Jianghanlin/Multiple_Voltage_Acquisition_System/Keyshot渲染/渲染图.png

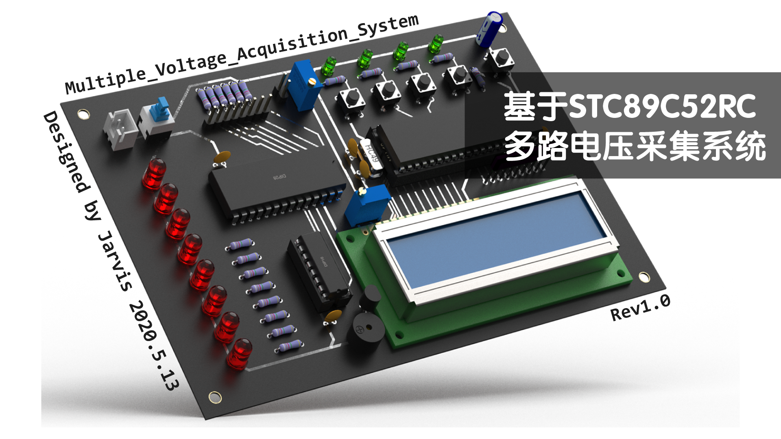
Keyshot渲染/渲染图.png
