Jianghanlin/Multiple_Voltage_Acquisition_System/报告/多通道采集控制系统-硬件.docx

目录

图目录

表目录

摘要

随着经济的飞速发展和科学技术水平的不断提高，智能数据采集系统在工业生产以及科学研究中得到了广泛的应用。在信息化时代，数据和信息无疑成为一种重要的资源，而数据采集系统的出现更是进一步促进了人机交互、对设备的自动检测控制等的实现，为现代化工业生产提供了方便。本次课程设计将阐述基于单片机的智能数据采集系统的设计要点及其具体方法，希望对基于单片机的智能数据采集系统的改造和创新做出应有的贡献。

此次课程设计利用型号为STC89C52RC的单片机，ADC0809，LCD1602，74HC138等电子元器件来实现对8通道模拟电压的采集并显示的功能。

关键字：电压采集、单片机、STC89C52、A/D转换

Abstract

With the rapid development of economy and the continuous improvement of science and technology, intelligent data acquisition system has been widely used in industrial production and scientific research. In the information age, data and information undoubtedly become an important resource, and the emergence of data acquisition system further promotes the realization of man-machine interaction and automatic detection and control of equipment, providing convenience for modern industrial production. This course design will elaborate the design essentials and specific methods of the intelligent data acquisition system based on the single chip microcomputer, hoping to make due contributions to the transformation and innovation of the intelligent data acquisition system based on the single chip microcomputer.

This course design USES the model STC89C52RC single-chip microcomputer, ADC0809, LCD1602, 74HC138 and other electronic components to realize the function of collecting and displaying the 8-channel analog voltage.

Key words: voltage acquisition, SCM, STC89C52, A/D conversion

# 多路数据采集控制系统

# 1 设计题目

单片机多路数据采集控制系统—实物制作。

# 2 设计目的

运用单片机原理及其应用等课程知识,根据题目要求进行软硬件系统的设计和调试，从而加深对本课程知识的理解，把学过的比较零碎的知识系统化，比较系统的学习开发单片机应用系统的基本步骤和基本方法，使学生应用知识能力、设计能力、调试能力以及报告撰写能力等有一定的提高。

# 3 设计内容及要求

用8051单片机设计数据采集控制系统，基本要求如下：

1、 可实现8路数据的采集，假设８路信号均为0-5V的电压信号；

2、 采集数据可通过LCD显示，显示格式为：[通道号] 电压值，如[０１]： ４.5V

3、 可通过键盘设置采集方式；（单点采集、多路巡测、采集时间间隔*）

4、 具有异常数据声音报警功能：对第一路数据可设置正常数据的上限值和下限值，当采集的数据出现异常，发出报警信号。

根据本人的设计，在原来基本要求的基础上，增加以下新增功能：

  1、 8路通道都可以单独设置上下限电压值并且可以人为通过按键调节并显示在LCD1602上，随时唤醒且自动保存数值。
  2、 通道电压不符合上下限值时，蜂鸣器打鸣，同时会有对应通道LED报警。
  3、 增加电源上电指示LED。
  4、 防止烧坏芯片，增加电源正负极插反指示LED。

# 4 总体设计

## 4.1 系统框图

此次多路数据采集控制系统包括：控制模块，电压采样模块，显示模块，按键模块，时钟模块，报警模块。

控制模块为单片机为STC89C52RC。电压采样模块为8位的AD转换芯片0809。显示模块为LCD1602A液晶显示屏。按键模块有按键、上拉电阻、LED构成。时钟模块为外接12MHz晶振。报警模块有声音报警模块和LED报警模块，声音报警模块由蜂鸣器和三极管构成；LED报警模块由74HC138和LED构成。另外还有其他滤波电容、电阻、LED等元件。其电路总设计框图如下：

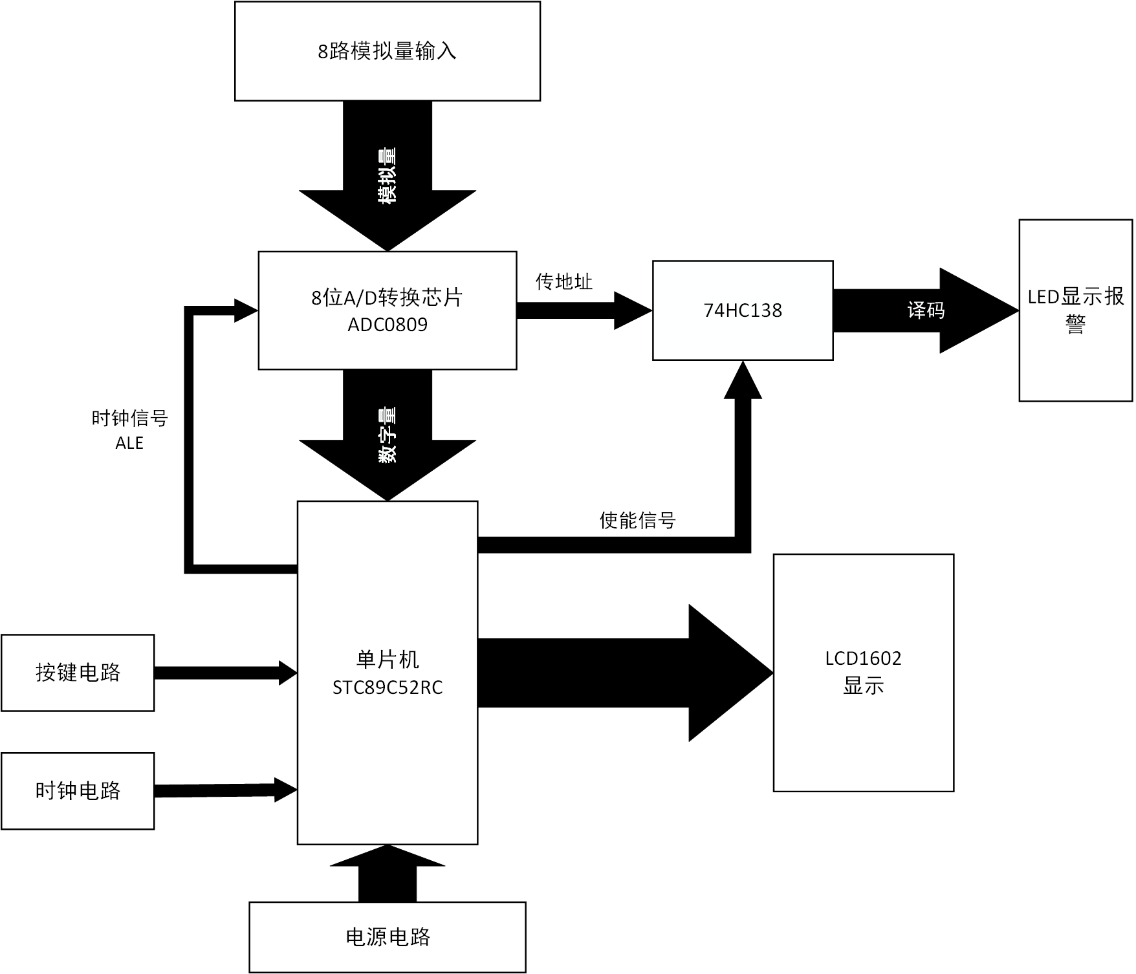
[picture p2: figure]

图 1-系统框图

## 4.2 关键元件选取

(1) STC89C52RC

STC89C52RC是STC公司生产的一种低功耗、高性能CMOS8位微控制器，具有8K字节系统可编程Flash存储器。STC89C52使用经典的MCS-51内核，但是做了很多的改进使得芯片具有传统的51单片机不具备的功能。在单芯片上，拥有灵巧的8 位CPU 和在系统可编程Flash，使得STC89C52为众多嵌入式控制应用系统提供高灵活、超有效的解决方案。

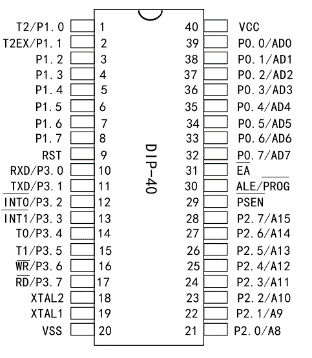
[picture p3: figure]

32 位I/O 口线，看门狗定时器，内置4KB EEPROM，MAX810复位电路，3个16 位定时器/计数器，4个外部中断，一个7向量4级中断结构（兼容传统51的5向量2级中断结构），全双工串行口。另外 STC89C52 可降至0Hz 静态逻辑操作，支持2种软件可选择节电模式。空闲模式下，CPU 停止工作，允许RAM、定时器/计数器、串口、中断继续工作。

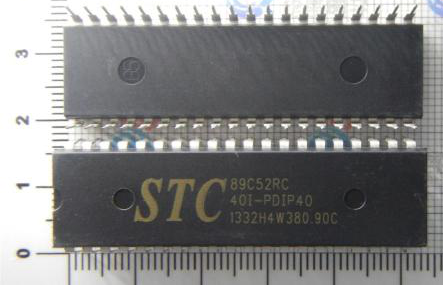
[picture p4: figure]

图 2- STC89C52实物图

图 3- STC89C52引脚图

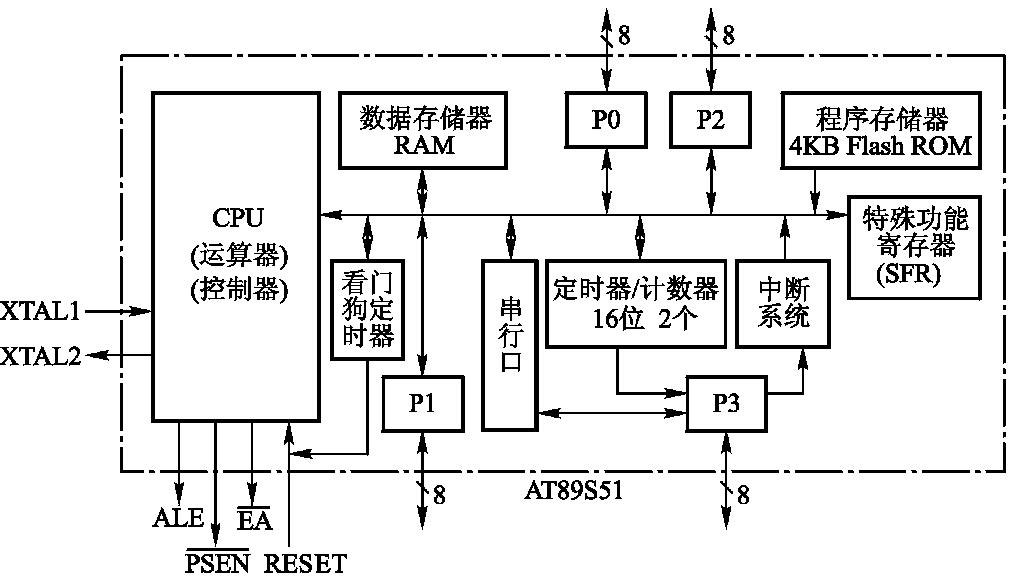
[picture p5: figure]

图 4- STC89C52内部结构

1、数据存储器（RAM）：片内为128B（52子系列为256B），片外最多可扩64KB。片内128B的RAM以高速RAM的形式集成，可加快单片机运行的速度和降低功耗

2、程序存储器（Flash ROM）：片内集成有8KB的Flash存储器，如片内容量不够，片外可外扩至64KB

3、中断系统：具有6个中断源，2级中断优先权

4、定时器/计数器：2个16位定时器/计数器（52子系列有3个），4种工作方式

5、看门狗定时器WDT：当CPU由于干扰使程序陷入死循环或跑飞时，WDT可使程序恢复正常运行

关键引脚

RESET：复位信号输入，在引脚加上持续时间大于2个机器周期的高电平，可使单片机复位。正常工作，此脚电平应 ≤ 0。5V。当看门狗定时器溢出输出时，该脚将输出长达96个时钟振荡周期的高电平

EA ：1，读取内部存储器。0，读取外部存储器。

ALE：为CPU访问外部程序存储器或外部数据存储器提供地址锁存信号，将低8位地址锁存在片外的地址锁存器中。

(2) ADC0809

ADC0809是采用COMS工艺制造的双列直插式单片8位A/D转换器。分辨率8位，精度7位，带8个模拟量输入通道，有通道地址译码锁存器，输出带三态数据锁存器。启动信号为脉冲启动方式，最大可调节误差为±1LSB。ADC0809内部没有时钟电路，故CLK时钟需由外部输入，fclk允许范围为500kHz-1MHz，典型值为640kHz。每通道的转换需要66~73个时钟脉冲，大约100-110us。（转换时间）工作温度范围为-40℃—+85℃。功耗为15mW，输入电压范围为0–5V，单一+5V电源供电。

IN0~IN7：8路模拟信号输入端。

D0~D7：8位数字量输出端。

START：启动控制输入端，高电平有效，用于启动ADC0809内部的A/D转换过程。

ALE：地址锁存控制输入端，ALE端可与START端连接在一起，通过软件输入一个正脉冲，可立即启动A/D转换。

EOC：转换结束信号输出端，开始A/D转换时为低电平，转换结束是输出高电平。

OE：输出允许控制端，用于打开三态输出锁存器，当OE为高电平时，打开三态数据输出锁存器，将转换后的数据凉输送到数据总线上。

CLK：始终信号输入端。

ADDA(ADDB、ADDC)：8路模拟选通开关的3位地址选通输入端。

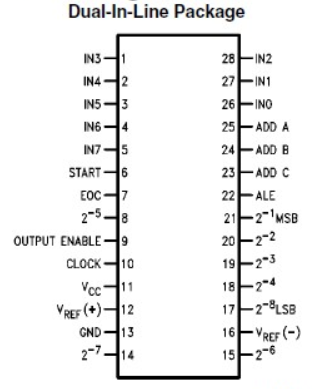
[picture p6: figure]
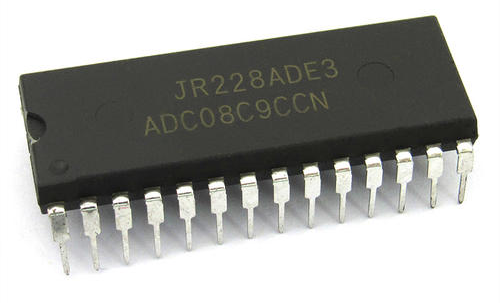
[picture p7: figure]

图 5-ADC0809引脚

图 6-ADC0809实物图

(3) LCD1602

LCD1602液晶显示器是广泛使用的一种字符型液晶显示模块。它是由字符型液晶显示屏（LCD）、控制驱动主电路HD44780及其扩展驱动电路HD44100，以及少量电阻、电容元件和结构件等装配在PCB板上而组成。

图 7-LCD俯视图

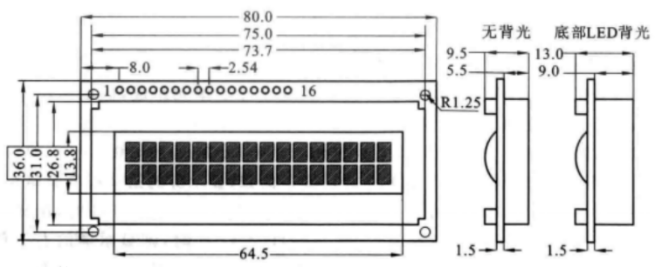
[picture p8: figure]
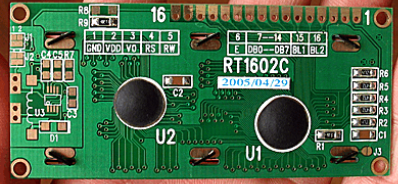
[picture p9: figure]

图 8-背部视图

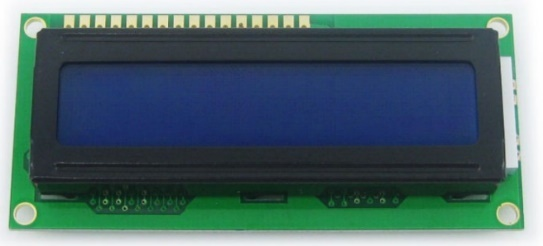
[picture p10: figure]
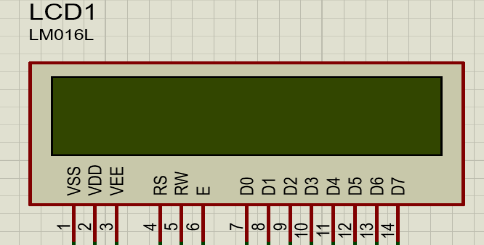
[picture p11: figure]

图 9-LCD实物图

图 10-对应引脚

·引脚1：VSS为地电源。

·引脚2：VDD接5V正电源。

·引脚3：VL为液晶显示器对比度调整端，接正电源时对比度最弱，接地时对比度最高，对比度过高时会产生“鬼影”现象，使用时可以通过一个10kQ的电位器调整其对比度。

·引脚4：RS为寄存器选择脚，高电平时选择数据寄存器、低电平时选择指令寄存器。

·引脚5：R/W为读/写信号线，高电平时进行读操作，低电平时进行写操作。当RS和R/W共同为低电平时可以写入指令或显示地址；当RS为低电平，R/W为高电平时，可以读忙信号；当RS为高电平，R/W为低电平时，可以写入数据。

·引脚6：E端为使能端，当E端由高电平跳变为低电平时，液晶模块执行命令。

·引脚7~14：D0~D7为8位双向数据线。

·引脚15：背光源正极。

·引脚16：背光源负极

(4) 74HC138

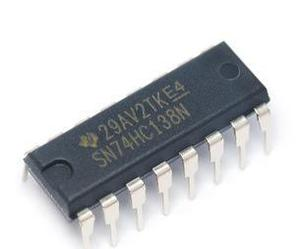
[picture p12: figure]
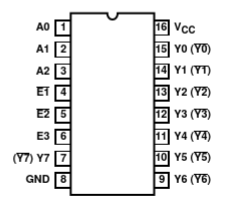
[picture p13: figure]

74HC238能够将3地址输入，译码出8个输出。

图 11-实物图

图 12-引脚图

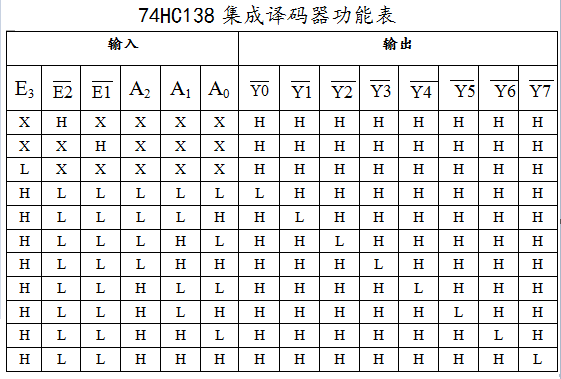
[picture p14: figure]

图 13-74HC138真值表

用3个IO，可以控制8个输出。A0~A2：3个输入。、：拉低使能，可以接地。E3：拉高使能，可以接VCC。：8个输出。

# 5 PCB设计，基于Altium Designer 20

步骤一：打开软件，新建原理图，新建PCB图。

步骤二：从库中寻找元器件绘制电路，并选择封装。

步骤三：进行原理图进行电气规则检查，检查无误后待定。

步骤四：进入PCB图在Keep Out Layer绘制PCB框的大小为80mm*120mm。

步骤五：导出原理图至PCB，规定布线规则后，开始布局和布线。

注意点个人陈述：

1、 考虑到电源的波动，在靠近所有芯片的供电引脚处都加有10nF的滤波电容，保持供电稳定，消除高频干扰。
2、 ADC0809的采样模拟电压来源为电阻分压电路。
3、 STC89C52RC的P0口没有上拉电阻需要人为添加排阻进行上拉。

## 5.1 原理图设计

(1) 控制及LCD显示模块

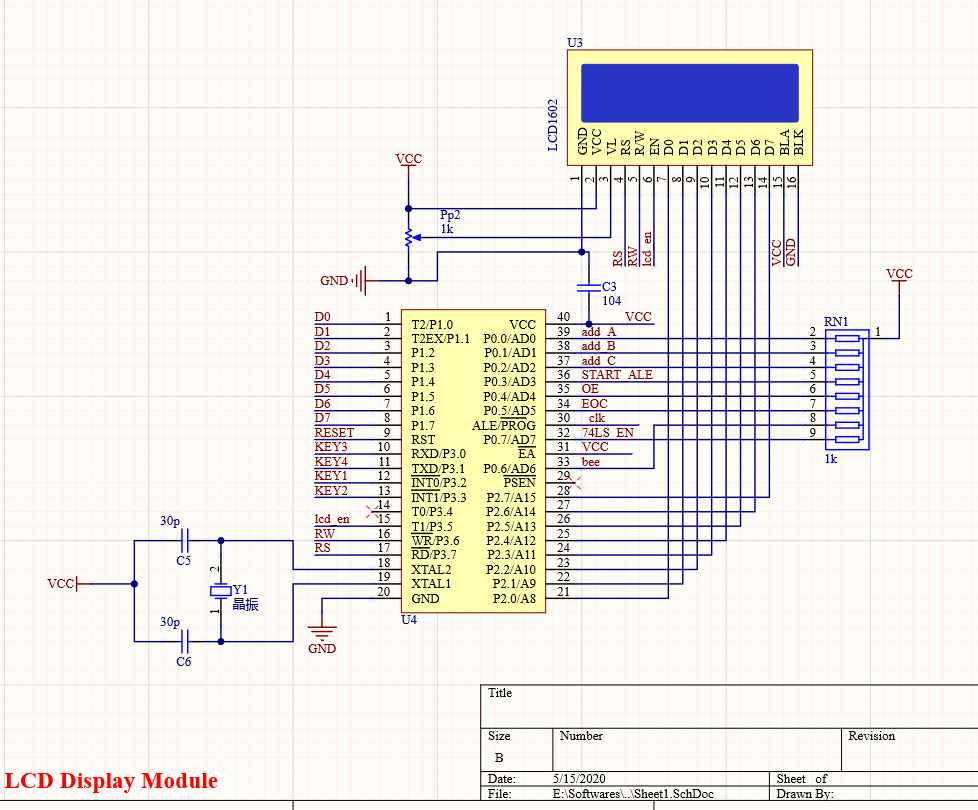
[picture p15: figure]

图 14-控制及LCD显示模块

晶振与单片机的脚XTAL0和脚XTAL1构成的振荡电路中会产生谐波（也就是不希望存在的其他频率的波）这个波对电路的影响不大，但会降低电路的时钟振荡器的稳定性。

为了电路的稳定性起见 ATMEL公司只是建议在晶振的两引脚处接入两个10pf-50pf的瓷片电容接地来削减谐波对电路的稳定性的影响，所以晶振所配的电容在10pf-50pf之间都可以的。

如上图所示LCD的VL引脚上的电压由滑动变阻器分压得到，用于调节LCD的对比度。BLA为外接电源的正极，BLK为外接电源的负极，用于LCD的背光。STC89C52RC的P2口驱动D0~D1，另外的3个IO，P3.5、P3.6、P3.7分别控制EN、RW、RS。

(2) 电压采样模块

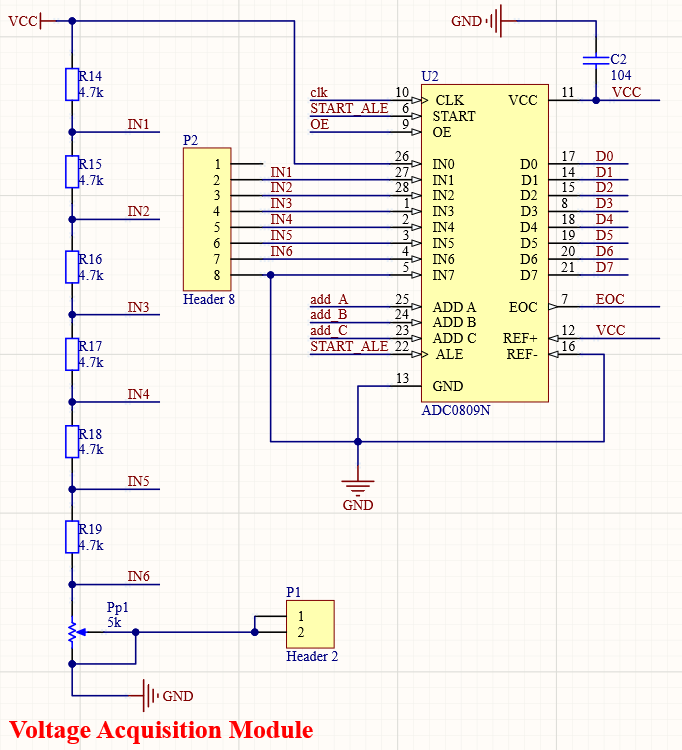
[picture p16: figure]

图 15-电压采样模块

如上图，ADC0809的3地址输入引脚CBA、ALE、EOC、START、OE由STC89C52RC上的IO引脚来控制。8位OUT输出直接由TC89C52RC的P1口来接收。ADC0809的8通道模拟信号输入由外部的电阻分压得到。另外需注意ADC0809芯片工作需要时钟脉冲，所以10引脚的clk由STC89C52RC的30引脚ALE进行供给，因为STC89C52RC正常工作时ALE引脚输出1/6的外接晶振的频率。

假设下方滑动变阻器为2.5K为例，IN7的电压接地为0V，其他根据5V分压可以得到：

IN0：5V

IN1：4.23V

IN2：3.4V

IN3：2.70V

IN4：1.93V

IN5：1.17V

IN6：0.4V

(3) 按键模块

按键模块如下图所示，分为前一通道、后一通道、调节上限、调解下限，还有复位按键。上拉电阻在上电时默认将按键右端置为高电平。一旦按键按下，电阻下方为低电平并传给STC89C52RC对应按键引脚，执行对应操作，并且会有对应LED亮起。

复位电路工作原理是VCC上电时，使极性电容C充电，在200欧电阻上出现高电位电压，使得单片机复位；几个毫秒后，C充满，200欧电阻上电流降为0，电压也为0，使得单片机进入工作状态。工作期间，按下S1，C放电，放电结束后，又充电，在200电阻上出现高电压，使得单片机进入复位状态，直到S1松手，C又充电完毕，随后，单片机进入工作状态。

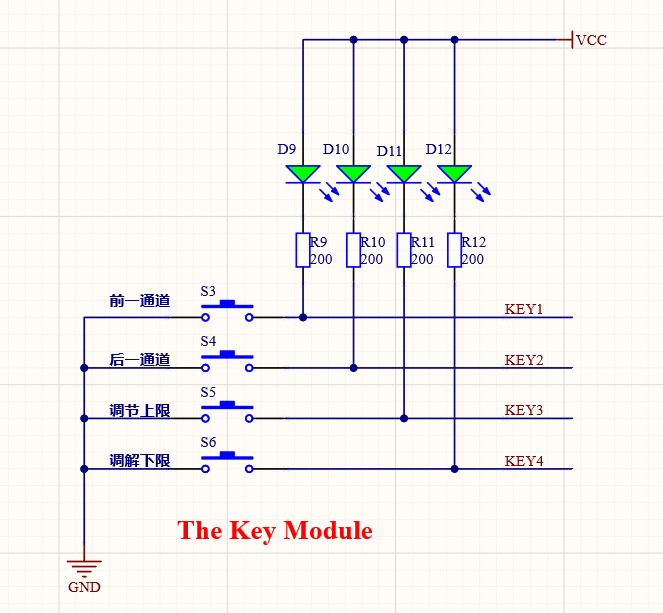
[picture p17: figure]
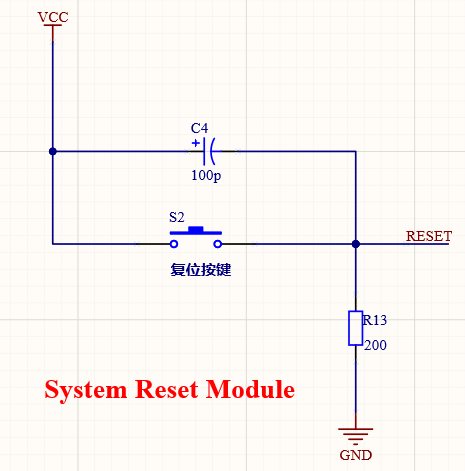
[picture p18: figure]

图 16-LCD控制按键模块

图 17-复位按键

(4) 报警模块。

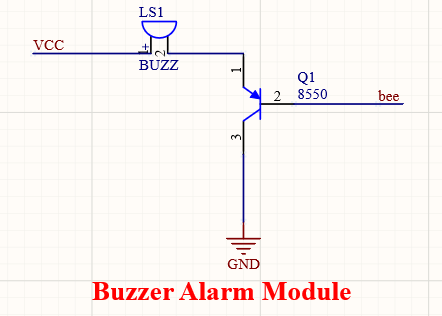
[picture p19: figure]

图 18-蜂鸣器报警模块

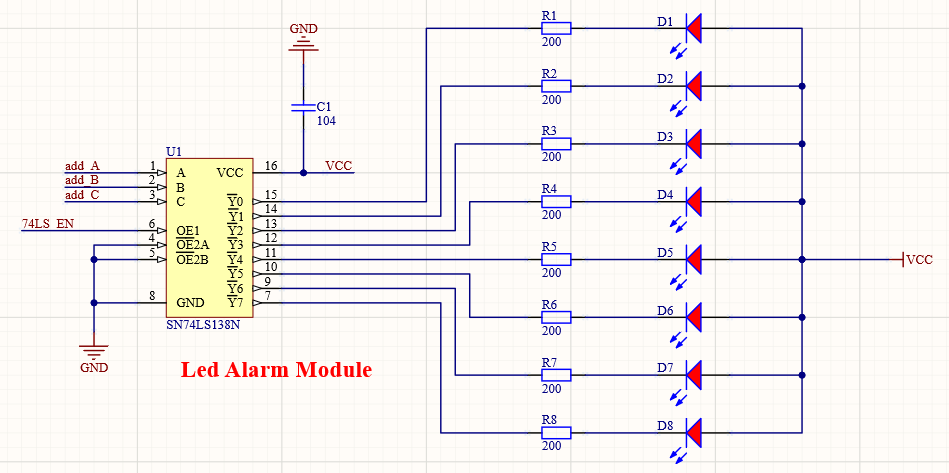
[picture p20: figure]

图 19-LED报警模块

如上图所示，74HC138的CBA由ADC0809的CBA传输共享而来，高电平有效使能端E3交由STC89C52RC的32引脚控制，其他2个低电平有效使能端、默认接地。一旦切换到对应通道，如果该通道的电压异常（即采样电压值不在设置的上下限电压区间范围内），那么点亮该通道的LED，进行报警，同时蜂鸣器进行打鸣报警。

## 5.2 PCB绘制

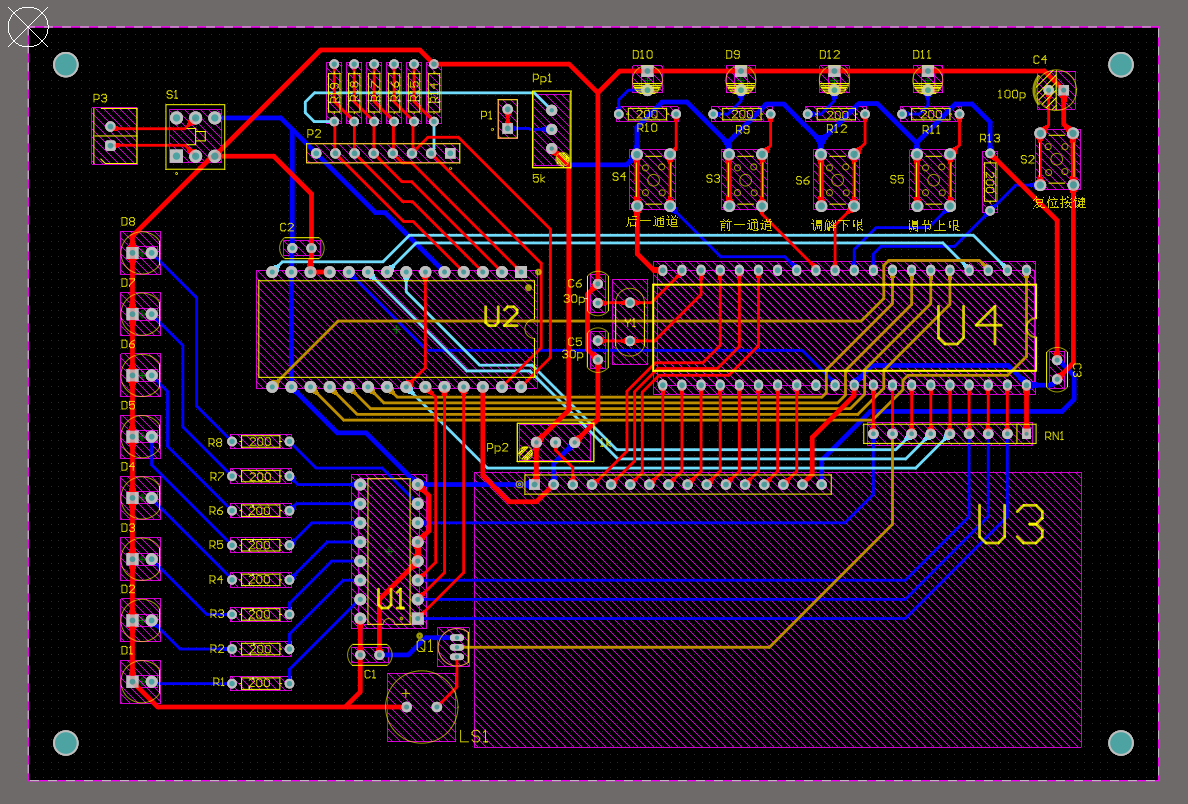
[picture p21: figure]

图 20-PCB绘制

# 6 调试及结果

## 6.1 Hex文件烧录过程

首先在Keil uVersion5中定义程序输出路径，进行编译，确保编译成功，如下图所示

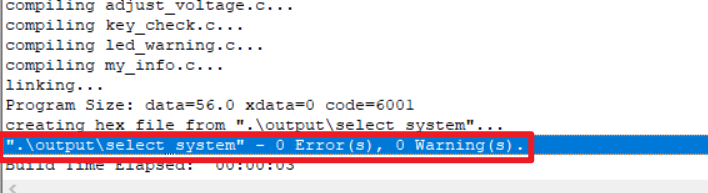
[picture p22: figure]

图 21-编译成功

接下来打开STC官方烧录软件，插上51开发板，窗口默认检测串口，波特率设置为9600~19200，选择hex文件所在的目录，点击下载，开发板上电，等待程序烧录完成即可。

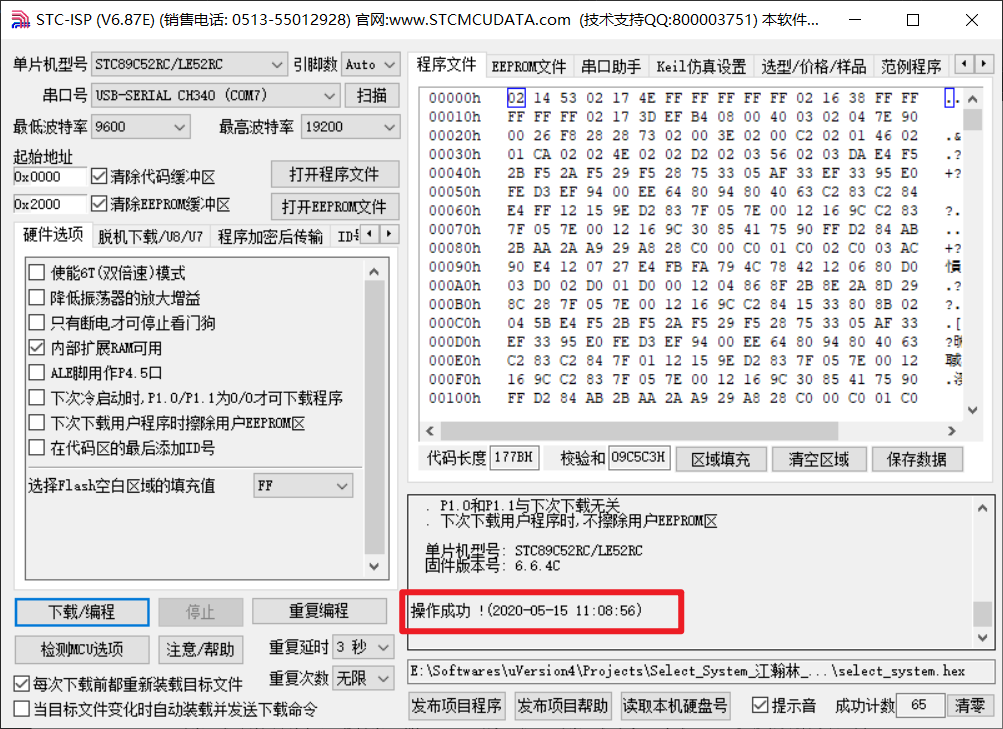
[picture p23: figure]

图 22-烧录成功

## 6.2 测试数据

第1组数据 | IN0 | IN1 | IN2 | IN3 | IN4 | IN5 | IN6 | IN7
万用表测量V | 5.00 | 4.288 | 3.536 | 2.762 | 1.986 | 1.214 | 0.458 | 0
LCD显示值V | 5.00 | 4.25 | 3.50 | 2.72 | 1.96 | 1.19 | 0.45 | 0
误差值V | 0 | 0.03 | 0.03 | 0.04 | 0.02 | 0.02 | 0 | 0
百分比 | 0.00% | 0.70% | 0.85% | 1.45% | 1.01% | 1.65% | 0.00% | 0.00%

图表 1-第一次测量数据

第2组数据 | IN0 | IN1 | IN2 | IN3 | IN4 | IN5 | IN6 | IN7
万用表测量V | 5.00 | 4.229 | 3.428 | 2.60 | 1.776 | 0.953 | 0.150 | 0
LCD显示值V | 5.00 | 4.19 | 3.41 | 2.58 | 1.76 | 0.94 | 0.13 | 0
误差值V | 0 | 0.03 | 0.01 | 0.02 | 0.01 | 0.01 | 0.02 | 0
百分比 | 0.00% | 0.71% | 0.29% | 0.77% | 0.56% | 1.05% | 13.33% | 0.00%

图表 2-第二次测量数据

实验测量数据如上两表所示，第一次测量数据的电压误差在0.03V上下波动，判断误差来源为3处：外用表、程序算法、硬件电路焊接、电子元件误差。由于万用表，电子元件误差是固定存在的，无法进行认为干预，并且硬件电路焊接也已完成，只能从程序入手，尽可能地使采样值准确。于是，在程序里考虑了多次采样求平均值的算法，编译成功并且烧录后，进行了第二次数据记录，结果取得了良好的效果，可以观察到电压误差在0.02V上下波动。

# 7 遇到的问题

(1) LCD1602A显示不正常，乱码

根据Proteus的硬件仿真，可以得出不是程序设计的问题，是电路焊接的问题。既然是LCD乱码，就是LCD与STC89C52连接的引脚上出了问题。LCD可以显示内容，对比度工作正常，排除调节对比度的3个引脚。背光电源正常亮起，排除背光电源的2个引脚。剩下11个引脚，经过观察是D0~D7某两个引脚短接，排除短接故障后，上电LCD只能显示半边内容，另外半边乱码。这个情况尝试直接换了一块LCD，显示正常，故障排除。

(2) LCD显示电压有0.03V的误差

直接从软件算法入手，采取多次采样求平均值的算法，采样次数为5次，重新测试后，发现有效果，电压误差为0.02V。

# 8 心得体会

我始终认为电子信息工程是一个非常有潜力的专业，并且我对该专业充满了浓厚的兴趣。虽然说专业课让我学得喘不过气来，难度颇大，但我相信这只是一个阶段性的过渡期。

属于工科的电子信息工程需要我有缜密的分析思维，强大的动手能力和学习能力，这些素养还需后期慢慢培养。时光荏苒，如今我就要大四了，在大学度过的3年里，我收获了许许多多宝贵的经验，积累了一定的专业知识与素养，回首看看两年前的自己，我发现自己已不再是刚进大学的是那个对专业一无所知的小白了。我清楚地知道目前我学到的只是专业的冰山一角，剩下的还需要我跟随老师的脚步，课外自己慢慢摸索。

此次的多路数据采集控制系统运用到了很多之前专业课的知识，尤其是数字电子技术，模拟电子技术。落实到具体的课程设计我才恍然大悟专业知识并不是白学的，原来是这么运用的，也难怪很久以前专业课老师每次上课都会给我们埋下伏笔。以前自己还没有这么深的感触，但越到后来的专业课程设计我渐渐感觉到专业课知识起到对课程设计的支配与指导作用。

多次AT89C52的课程设计让我对单片机有了更加深入的理解。本次课程设计最突出的特点，也是最关键的地方就是是芯片时序图分析，要使得芯片之间能够进行良好的通信，程序必须严格按照时序图来编写。ADC0809的时序图，还有LCD1602的时序图，之前一直不懂这个时序图干些什么作用，现在恍然大悟了。

我相信之后我还会遇到更大的困难，更大的挑战，不过本身也不就是一路解决问题，克服困难，提升自我的过程么。未来是未知的，我只有不断进步，不断去适应困苦的环境，才能超越自我，达到新的高度。

此次的课程设计，感谢陈渭力老师和陈淼老师的帮助，不管是在硬件电路设计上还是程序设计上他们都给了我特别大的启发。

# 附件

PCB正反面照片一张

Proteus仿真布局图一张

电路原理图一张

PCB布线图一张

PCB 3D渲染图一张

电子元件清单一张
