Jianghanlin/Multiple_Voltage_Acquisition_System/Select_System_江瀚林_Xb17610107/地址数据表_Designed by jianghanlin.xlsx

LCD位置排序 | 位置地址 | 写地址+80H | 数字 | 对应16进制
1 | 0 | 80 | 0 | 0x30
2 | 1 | 81 | 1 | 0x31
3 | 2 | 82 | 2 | 0x32
4 | 3 | 83 | 3 | 0x33
5 | 4 | 84 | 4 | 0x34
6 | 5 | 85 | 5 | 0x35
7 | 6 | 86 | 6 | 0x36
8 | 7 | 87 | 7 | 0x37
9 | 8 | 88 | 8 | 0x38
10 | 9 | 89 | 9 | 0x39
11 | A | 8A
12 | B | 8B
13 | C | 8C
14 | D | 8D
15 | E | 8E
16 | F | 8F
17 | 40 | C0
18 | 41 | C1
19 | 42 | C2
20 | 43 | C3
21 | 44 | C4
22 | 45 | C5
23 | 46 | C6
24 | 47 | C7
25 | 48 | C8
26 | 49 | C9
27 | 4A | CA
28 | 4B | CB
29 | 4C | CC
30 | 4D | CD
31 | 4E | CE
32 | 4F | CF
