Jianghanlin/Multiple_Voltage_Acquisition_System/芯片信息/ADC0809内部结构.png

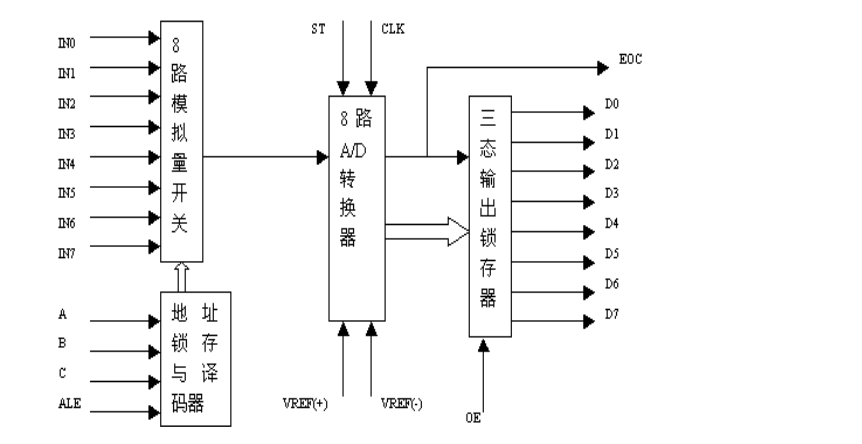
芯片信息/ADC0809内部结构.png
