Jianghanlin/Multiple_Voltage_Acquisition_System/芯片信息/AD转换时序.png

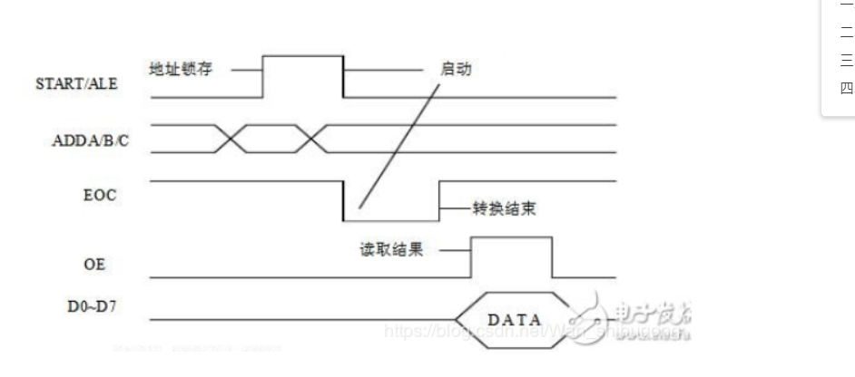
芯片信息/AD转换时序.png
