Jianghanlin/Multiple_Voltage_Acquisition_System/芯片信息/LCD1602点阵俯视.png

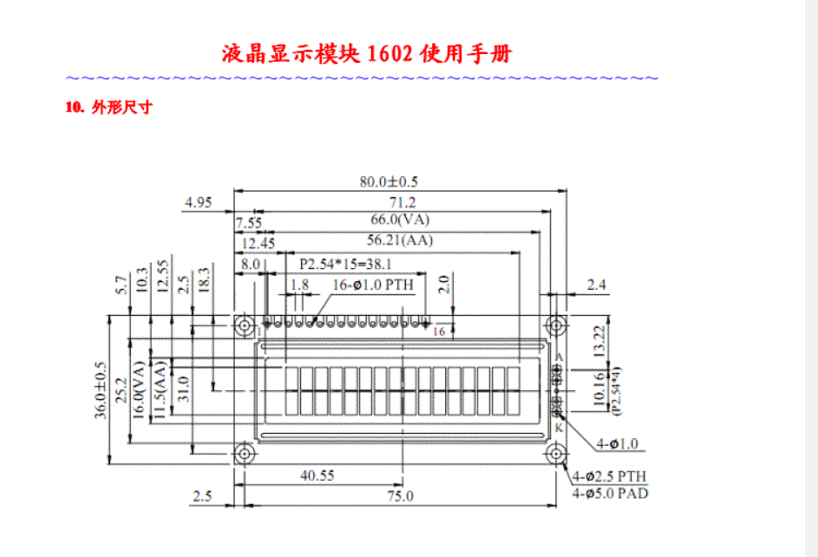
芯片信息/LCD1602点阵俯视.png
