Jianghanlin/Multiple_Voltage_Acquisition_System/芯片信息/LCD指令集.png

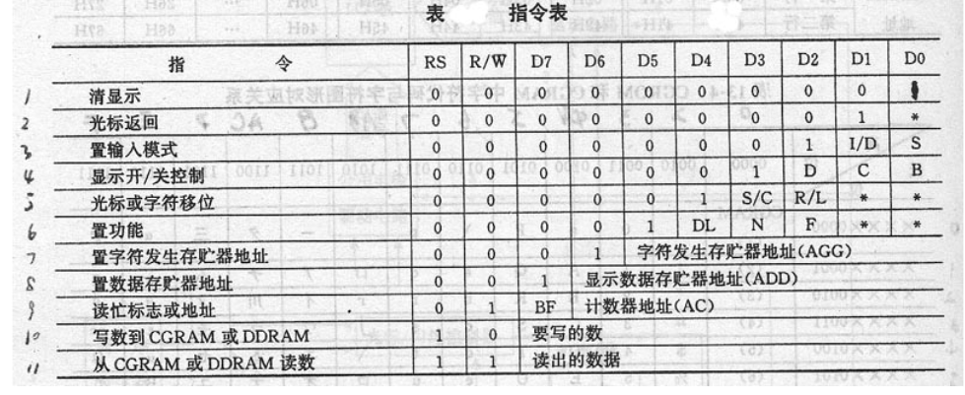
芯片信息/LCD指令集.png
