Jianghanlin/Multiple_Voltage_Acquisition_System/芯片信息/译码.png

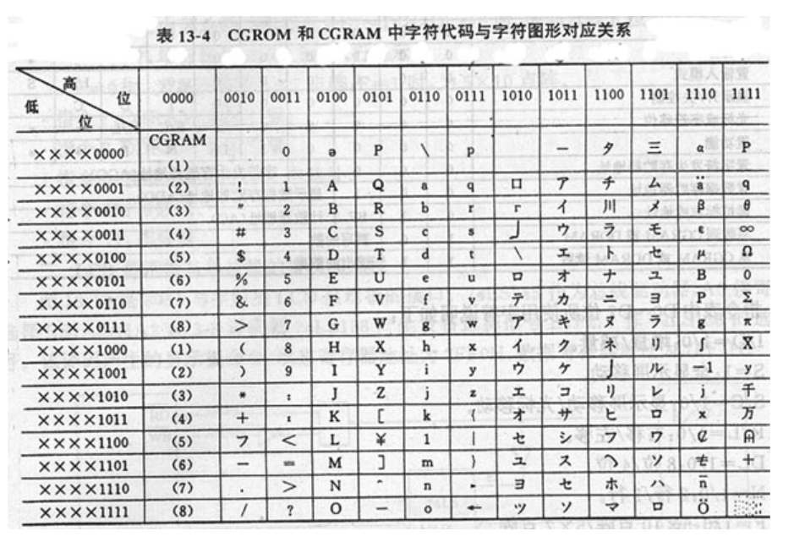
芯片信息/译码.png
