Jianghanlin/Multiple_Voltage_Acquisition_System/芯片信息/读时序.png

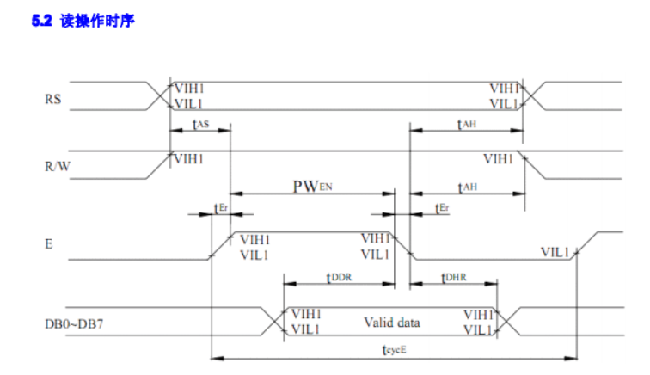
芯片信息/读时序.png
