Jianghanlin/Multiple_Voltage_Acquisition_System/报告材料/物料清单.xlsx

Comment | Description | Designator | Footprint | LibRef | Quantity
104 | Capacitor 瓷片电容 无极性电容 | C1, C2, C3 | CAP-0.1 | Cap_ceramic | 3
100p | Polarized Capacitor (Axial) | C4 | CAP 2.0*5*11 | Cap Pol2 | 1
30p | Capacitor 瓷片电容 无极性电容 | C5, C6 | CAP-0.1 | Cap_ceramic | 2
直径5mm的红灯 | 直径5mm的发光二极管 | D1, D2, D3, D4, D5, D6, D7, D8 | LED 5MM-R | LED_5#红灯 | 8
直径5mm的绿灯 | 直径5mm的发光二极管 | D9, D10, D11, D12 | LED 3MM-G | LED_5#绿灯 | 4
BUZZ | 蜂鸣器 | LS1 | Beep_small | BUZZ | 1
Header 2 | Header, 2-Pin | P1 | HDR1X2 | Header 2 | 1
Header 8 | Header, 8-Pin | P2 | HDR1X8 | Header 8 | 1
Header 2 | Header, 2-Pin | P3 | HX2.54-2 | Header 2 | 1
5k | 3296电位器 | Pp1 | RP_3296 | RP_3296 | 1
1k | 3296电位器 | Pp2 | RP_3296 | RP_3296 | 1
8550 | PNP型小功率三极管 | Q1 | TO-92(TO-92-3) | 8550_TO-92 | 1
200 | Resistor 直插电阻 0.5W | R1, R2, R3, R4, R5, R6, R7, R8, R9, R10, R11, R12, R13 | AXIAL-0.3-R | Res2_1/2W | 13
4.7k | Resistor 直插电阻 0.5W | R14, R15, R16, R17, R18, R19 | AXIAL-0.3-R | Res2_1/2W | 6
Res_Pack_Single | 排阻 | RN1 | RES-PACK-DIP9 | Res_Pack_Single | 1
自锁开关 | 自锁开关 | S1 | sw_8.5mm | SW DPDT | 1
复位按键 | Tactile Switch触觉开关 | S2 | BUTTON_6*6 | SW-PB | 1
前一通道 | Tactile Switch触觉开关 | S3 | BUTTON_6*6 | SW-PB | 1
后一通道 | Tactile Switch触觉开关 | S4 | BUTTON_6*6 | SW-PB | 1
调节上限 | Tactile Switch触觉开关 | S5 | BUTTON_6*6 | SW-PB | 1
调解下限 | Tactile Switch触觉开关 | S6 | BUTTON_6*6 | SW-PB | 1
SN74LS138N | 3-Line to 8-Line Decoder / Demultiplexer | U1 | DIP16-300_MH | SN74LS138N | 1
ADC0809N | CMOS Analog-to-Digital Converter with 8-Channel Multiplexer | U2 | DIP28-600 | ADC0809N | 1
LCD1602 |  | U3 | LCD1602 | LCD1602 | 1
AT89C52 | AT89C52RC_DIP40 | U4 | DIP-40 | AT89C52RC-DIP | 1
晶振 | 直插晶振11.05292/12/16/24/MHz | Y1 | cry卧式 | Crystal 11.05292/12/16/24/MHz | 1
