Jianghanlin/Multiple_Voltage_Acquisition_System/(list of files, cad)

Other CAD files:
Select_System_江瀚林_Xb17610107/Keil/output/main.obj
Select_System_江瀚林_Xb17610107/Keil/output/lcd_display.obj
Select_System_江瀚林_Xb17610107/Keil/output/adjust_voltage.obj
Select_System_江瀚林_Xb17610107/Keil/output/led_warning.obj
Select_System_江瀚林_Xb17610107/Keil/output/my_info.obj
Select_System_江瀚林_Xb17610107/Keil/output/lcd_init.obj
Select_System_江瀚林_Xb17610107/Keil/output/AT89C52_init.obj
Select_System_江瀚林_Xb17610107/Keil/output/key_check.obj
Select_System_江瀚林_Xb17610107/Keil/output/delay.obj
Select_System_江瀚林_Xb17610107/Keil/output/ADC.obj
