Jianghanlin/Multiple_Voltage_Acquisition_System/(list of files, drawings)

Other design files:
Select_System_江瀚林_Xb17610107/Altium/select_system/select_system.PrjPcb
Select_System_江瀚林_Xb17610107/Altium/select_system/Sheet1.SchDoc
Select_System_江瀚林_Xb17610107/simulation/select_system.pdsprj
