Jianghanlin/Multiple_Voltage_Acquisition_System/(commit log)

2020-08-24 Rev1.0
    第一次加入工程文件
    [ADC.obj, AT89C52_init.obj, Sheet1.SchDoc, adjust_voltage.obj, delay.obj, key_check.obj, lcd_display.obj, lcd_init.obj]
2020-08-24 Rev1.1
    项目站点构建成功
2020-08-25 Rev1.2
    删除Altium历史记录备份
2020-08-27 Rev1.3
    加入keyshot渲染文件，另外整理了一下文件夹
    [物料清单.xlsx]
2020-09-22 Rev1.4
    1、更改了一些PCB文件
2021-01-19 Rev1.5
    1、日常维护
